ManuUniverso/Solar-Monitor/MonitorSolarMenuTouchV110.jpg

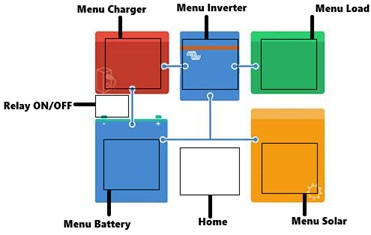
MonitorSolarMenuTouchV110.jpg
