ManuUniverso/Solar-Monitor/SolarMonito.jpg

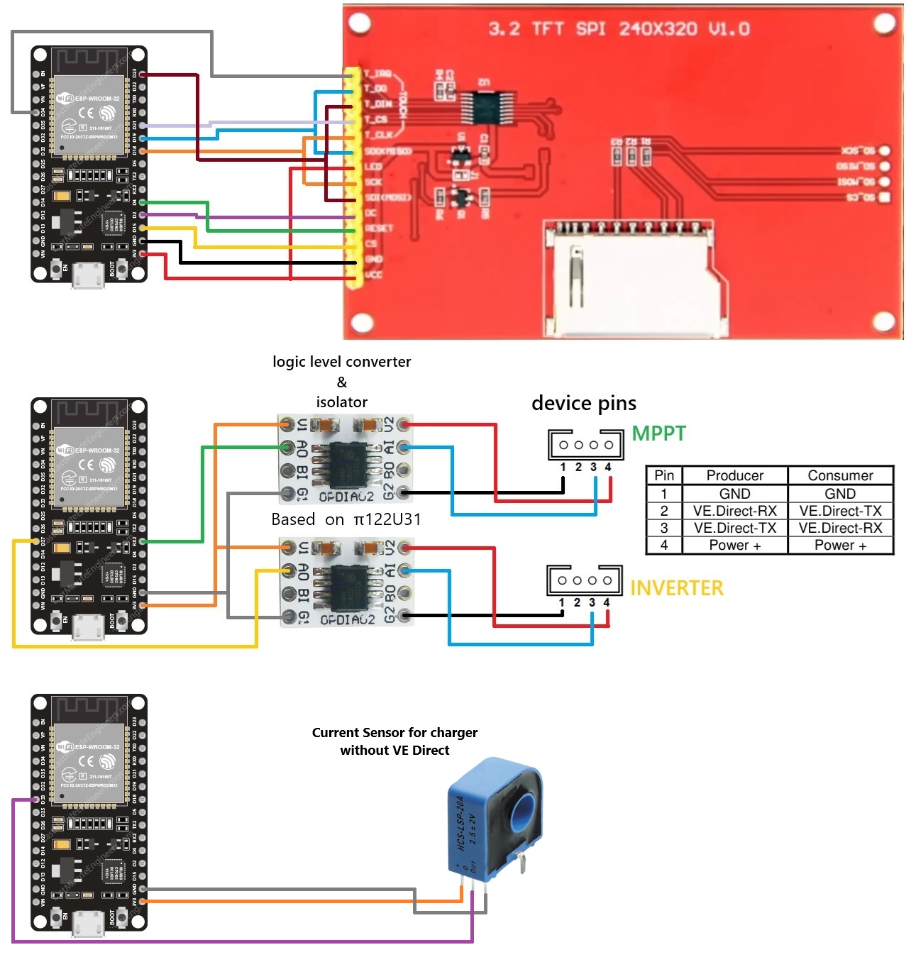
SolarMonito.jpg
