ManuUniverso/Solar-Monitor/(commit log)

2024-01-14 Solar Monitor v0.1.1 alfa
    It is the first version of the program, complete or practically complete.
    This version is still unstable and may have bugs or incomplete functionality.
    Using an ESP32, the data is read from the VE.Direct ports (Victron Energy brand) of the Inverter and MPPT.
    Then display the results on a color ili9341 screen.
    Taking advantage of the available touchscreen you can enter the submenu of each device.
    Much of the comments are in Spanish, you can translate but, the symbolic name of
    variables is often quite intuitive and easy to associate.
    Attention, it is necessary to use a logic level converter circuit
    to adapt the logic level to the ESP32 3.3v.
    Atte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
    [SolarMonitor0.1.1alfa.ino]
2024-01-23 Update Esquema
    Update of the scheme added a current sensor to control the load without a ve.direct port.
2024-01-23 Delete SolarMonitor.jpg
    Antiguo esquema sin current sensor ya no es valido para este esquema
2024-01-23 Update README.md
    Current Sensor add
2024-01-23 Update SolarMonitor.ino
    Added current sensor for charger control without VE.Direct. Improved and fixed many bugs.
    [SolarMonitor.ino]
2024-01-23 Current Sensro add 0.1.2
    Current Sensro add 0.1.2
2024-01-23 Current Sensor add
    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
2024-01-31 V0.1.2 to V1
    Added an LDR for dimming mode & Current sensor note for better accuracy
2024-02-15 Update SolarMonitor.ino
    1.1.1 FIX False positives due to read error reading must be confirmed "RelaySamp=255" times to activate automatic Relay mode VBAT low & WattHigh.
    [SolarMonitor.ino]
2024-03-29 Update SolarMonitor.ino
    1.1.2 Bug Fix from MenuHome
    [SolarMonitor.ino]
